blackjetrock/psion-speech-adapter/README.md

# psion-speech-adapter
Psion Organiser speech adatper
