blackjetrock/psion-speech-adapter/pcb/sp0256al2/psion-speech-sp0256al2/psion-speech-sp0256al2.kicad_pcb

## KiCad design pcb/sp0256al2/psion-speech-sp0256al2/psion-speech-sp0256al2.kicad_pcb (2023-04-02)

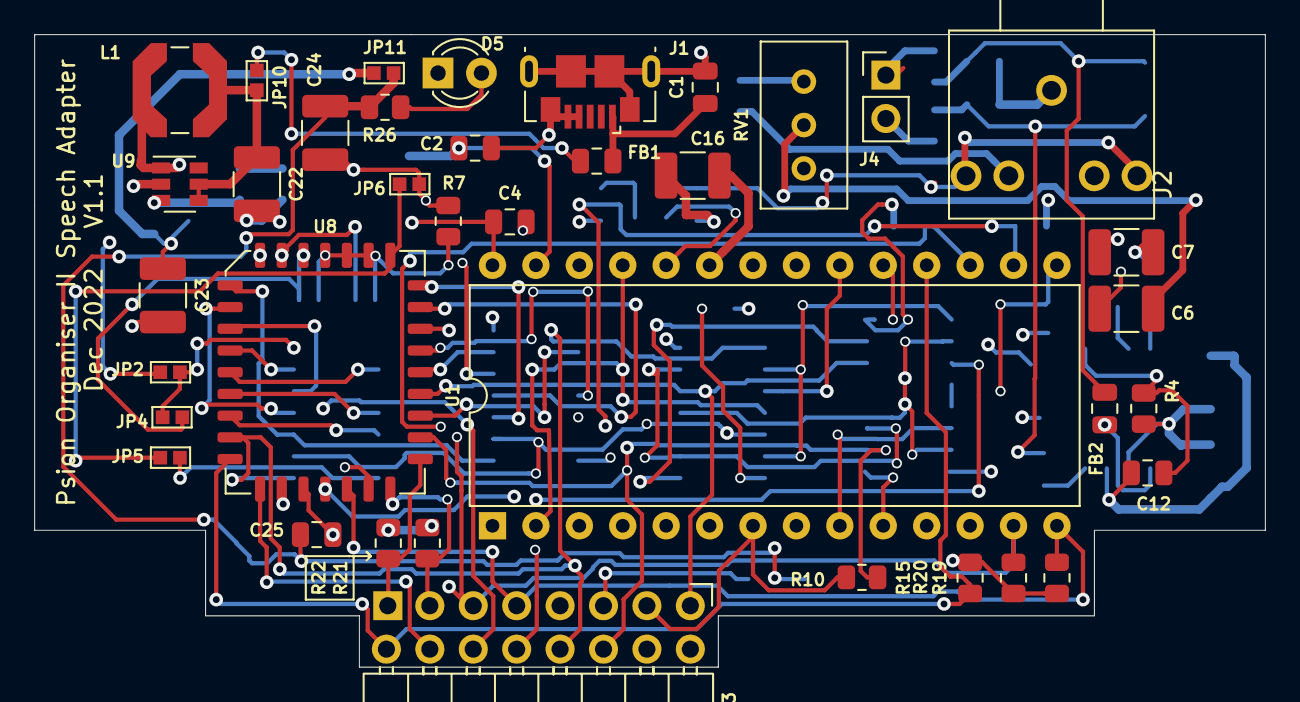
[picture p1: board psion-speech-sp0256al2.kicad_pcb from above]

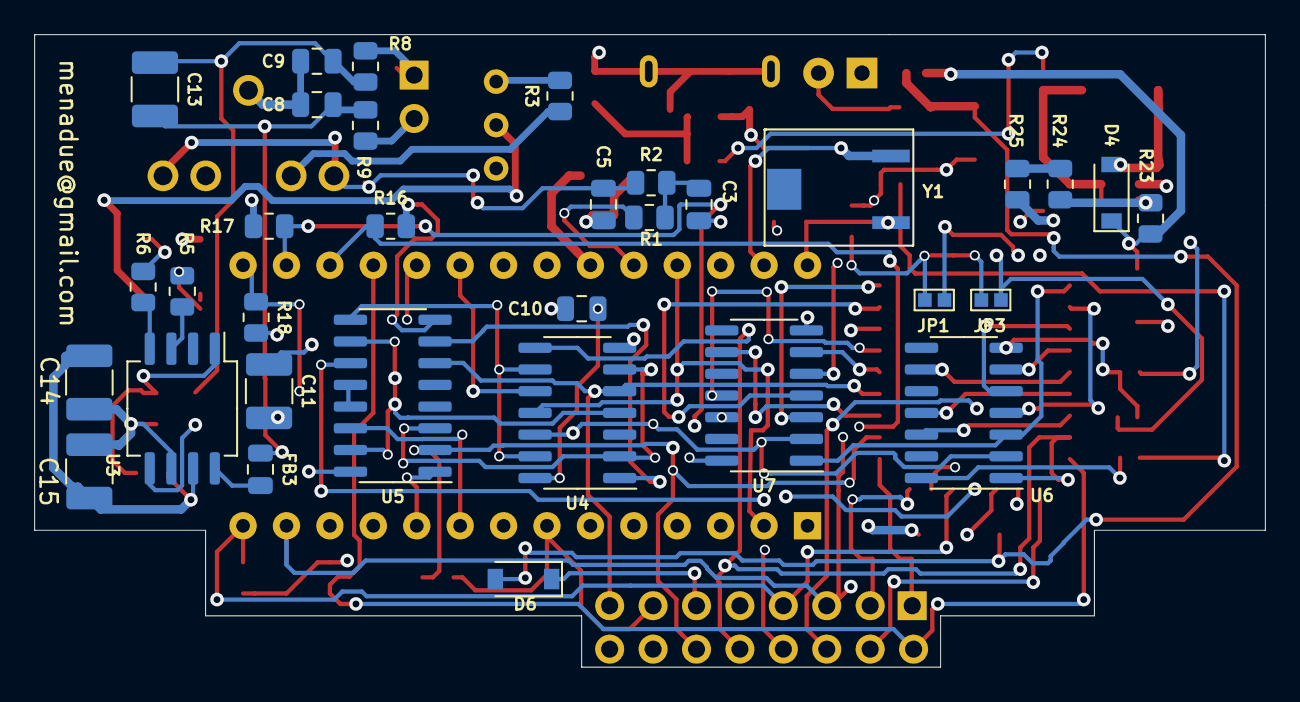
[picture p2: board psion-speech-sp0256al2.kicad_pcb from below]

Board: 4 copper layers, 72.0 x 37.0 mm, 71 parts (33 on the bottom side), 68 nets.

Parts:
C1: 10nF; C_0805_2012Metric
C2, C4: 12pF; C_0805_2012Metric
C3, C5: 22nF; C_0805_2012Metric
C6, C7: 1uF; C_1210_3225Metric_Pad1.33x2.70mm_HandSolder
C8, C9: 220pF; C_0805_2012Metric
C10, C12, C25: 100nF; C_0805_2012Metric
C11, C24: 10uF; C_1210_3225Metric_Pad1.33x2.70mm_HandSolder
C13: nopop; C_1210_3225Metric_Pad1.33x2.70mm_HandSolder
C14, C15, C16: 20uF; C_1210_3225Metric_Pad1.33x2.70mm_HandSolder
C22, C23: 22uF; C_1210_3225Metric_Pad1.33x2.70mm_HandSolder
D4, D6: SS36; D_SOD-123
D5: LED; LED_D3.0mm
FB1, FB2, FB3: Laird Technologies Part # MI0805K400R-10; C_0805_2012Metric
J1: Connector_USB_B_Micro; USB_Micro-B_GCT_USB3076-30-A
J2: AudioJack2_Ground_Switch; truconnect_stereo_audio_5_pin
J3: Conn_02x08_Odd_Even; Psion_datapak_2x08_P2.54mm_Horizontal
J4: Conn_01x02_Female; PinHeader_1x02_P2.54mm_Vertical
JP1, JP2, JP3, JP4, JP5, JP6, JP10: Jumper_NO_Small; SolderJumper-2_P1.3mm_Open_Pad0.8x0.8mm
JP11: SolderJumper_2_Open; SolderJumper-2_P1.3mm_Open_Pad0.8x0.8mm
L1: 22uH; L_Coilcraft_LPS5030
R1, R2: 33K; R_0805_2012Metric
R3: 0R; R_0805_2012Metric
R4: 10k; R_0805_2012Metric
R5, R6: 100R; R_0805_2012Metric
R7, R10, R15, R16, R17, R18, R19, R20, R21, R22: 47k; R_0805_2012Metric
R8, R9: R_Small; R_0805_2012Metric
R23: 100k; R_0805_2012Metric
R24: 5k; R_0805_2012Metric
R25: 1k; R_0805_2012Metric
R26: 1k8; R_0805_2012Metric
RV1: 10k; Potentiometer_Bourns_3296W_Vertical
U1: SP0256AL2; DIP-28_W15.24mm
U3: PAM8302AAD; SO-8_5.3x6.2mm_P1.27mm
U4: 4011; SOIC-14_3.9x8.7mm_P1.27mm
U5: 74LS368; SOIC-16_3.9x9.9mm_P1.27mm
U6, U7: 4024; SOIC-14_3.9x8.7mm_P1.27mm
U8: SST39SF020; PLCC-32_11.4x14.0mm_P1.27mm
U9: Regulator_Switching_MT3608; SOT-23-6
Y1: 3.2768MHz; crystal_um4s

Connections:
5VUSB: FB1.1, JP10.1
+10V_PSION: C24.1, C25.1, D6.2, JP11.2, R26.1
A15: JP1.1, JP2.1, U8.3
A16: JP3.1, JP4.1, U8.2
A17: JP5.1, JP6.1, U8.30
ALD: U1.20, U4.10
GND: C1.2, C2.2, C3.2, C4.2, C5.2, C7.2, C8.2, C9.2, C10.2, C11.2, C12.2, C14.2, C15.2, C16.2, C22.2, C23.2, C24.2, C25.2, D5.1, J1.4, J1.5, J1.6, J2.G, J3.9, JP2.2, JP4.2, JP6.2, R7.2, R15.2, R16.2, R17.2, R18.2, R19.2, R20.2, R21.2, R22.2, R25.2, RV1.3, U1.1, U1.10, U1.11, U1.22, U3.7, U4.7, U5.1, U5.8, U6.7, U7.7, U8.16, U9.2
LRQ: U1.9, U5.14
NOT_SEL_SOE_1: U4.9, U4.13, U5.9
N_SOE: U4.1, U5.7
N_SS: U4.2, U4.6, U5.3
unnamed: C1.1, FB1.2, J1.1
unnamed: C2.1, U1.27, Y1.1
unnamed: C3.1, R1.1, R2.2
unnamed: C4.1, U1.28, Y1.2
unnamed: C5.1, J2.S, J2.T, R2.1
unnamed: C6.1, R5.2
unnamed: C6.2, RV1.2
unnamed: C7.1, R6.2
unnamed: C12.1, R4.2, U3.1
unnamed: C9.1, C13.1, FB2.1, R8.2
unnamed: C8.1, C13.2, FB3.1, R9.1
unnamed: C22.1, JP10.2, L1.1, U9.4, U9.5
unnamed: C23.1, D4.1, JP11.1, R23.1
unnamed: D4.2, L1.2, U9.1
unnamed: D5.2, R26.2
unnamed: FB2.2, U3.5
unnamed: FB3.2, U3.8
unnamed: J2.SN, R3.1
unnamed: J4.1, R8.1
unnamed: J4.2, R9.2
unnamed: R1.2, U1.24
unnamed: R3.2, RV1.1
unnamed: R5.1, U3.3
unnamed: R6.1, U3.4
unnamed: R23.2, R24.1, U9.3
unnamed: R24.2, R25.1
unnamed: U5.12, U5.13
unnamed: U6.3, U7.1, U8.5
unnamed: U6.4, U8.6
unnamed: U6.5, U8.7
unnamed: U6.6, U8.8
unnamed: U6.9, U8.9
unnamed: U6.11, U8.10
unnamed: U6.12, U8.11
unnamed: U7.3, U8.29
unnamed: U7.4, U8.28
unnamed: U7.5, U8.4
unnamed: U7.6, U8.25
unnamed: U7.9, U8.23
unnamed: U7.11, U8.26
unnamed: U7.12, U8.27
RST: U1.2, U1.25, U4.11
SCLK: J3.10, U4.8, U6.1, U8.12
SD0: J3.2, R15.1, U1.18, U8.13
SD1: J3.4, R16.1, U1.17, U8.14
SD2: J3.6, R17.1, U1.16, U8.15
SD3: J3.8, R18.1, U1.15, U8.17
SD4: J3.7, R19.1, U1.14, U8.18
SD5: J3.5, R20.1, U1.13, U8.19
SD6: J3.3, R21.1, U8.20
SD7: J3.1, R22.1, U5.11, U8.21
SEL_SOE_1: U4.4, U5.10, U5.15
SMR: J3.16, U4.12, U6.2, U7.2
SOE: J3.15, U4.5, U5.6, U8.24
SS: J3.12, R10.2, U5.2, U8.22
SVCC: C10.1, C11.1, C14.1, C15.1, C16.1, J3.13, JP1.2, JP3.2, JP5.2, R4.1, R7.1, R10.1, U1.7, U1.19, U1.23, U3.6, U4.14, U5.16, U6.14, U7.14, U8.1, U8.31, U8.32
VB: D6.1, J3.11
